scubaben/MixMonitor/(threads)

Thread 1 (2017-06-21):

display mv reading of cells

scubaben, 2017-06-21:
currently, MV readings are only shown while calibrating.  it would be nice to have the option to see MV readings during analysis too.

scubaben, 2017-06-26:
added the mV readings to the right side of the screen by default

Closed 2017-06-26.

Thread 4 (2017-06-21):

add a settings menu

scubaben, 2017-06-21:
there are a handful of new enhancements that will require new menus to configure.  Clicking the button should first bring up a menu, and then allow the user to choose which settings they want to modify.

maybe something like:
- calibrate
- display theroretical HE
- turn cells on or off
- calculate blend
- set targets manually

scubaben, 2017-06-23:
menus:
-calibrate
-set target blend (specify o2/he)
-set target o2 readings (specify sensor readings directly)
-set alarm (three options: off, alarm on O2, alarm on target blend and tolerance)
-display Setup (controls what is shown on the right side of the screen)
--Show sensor MV
--Show target O2
--Show target mix vs theoretical mix

Closed 2017-06-25.

Thread 5 (2017-06-21):

Add battery monitoring

scubaben, 2017-06-21:
the feather uses a voltage divider on pin A9, which we can use to read the voltage of the rechargable battery pack.
https://learn.adafruit.com/adafruit-feather-32u4-basic-proto/power-management

sample code:
#define VBATPIN A9

float measuredvbat = analogRead(VBATPIN);
measuredvbat *= 2;    // we divided by 2, so multiply back
measuredvbat *= 3.3;  // Multiply by 3.3V, our reference voltage
measuredvbat /= 1024; // convert to voltage
Serial.print("VBat: " ); Serial.println(measuredvbat);

scubaben, 2017-06-23:
added function to get battery voltage, currently displayed on the startup screen.  as a side note, I've had the analyzer running for over 24 hours now on a 2000 mah battery and it is still at 3.93v

Closed 2017-06-23.

Thread 9 (2017-07-19):

Sensor class needs some cleanup

notjj, 2017-07-19:
Currently sensor class references global variables, so it is not possible to use it independent of the project... so it should be refactored to not do this.

scubaben, 2017-07-19:
Good callout, it looks like target tolerance is the offending variable - did you spot others?

notjj, 2017-07-20:
Just saw the tolerance pop up in the errors, so I believe it is the only
one. We should probably do per-sensor tolerance even if we set them both
the same at the moment... I could see you possibly being ok with more drift
in one but not the other.

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

scubaben, 2017-07-20:
Made target tolerance a member of the sensor class and eliminated the global variable.

Closed 2017-07-20.
