scubaben/MixMonitor/(commit log)

2017-06-23 improved display and added battery
    created function to read battery voltage and made preparations for adding HE/ MV info to screen by using strings to improve the way decimals are printed (only one decimal place now).
2017-06-25 Added settings menu and divided display
    need to clean up code for calculating when the sensors are within tolerance. do a thorough code review for cleanup opportunities and add code for mix setting still.
    [_2Sensor_Oxygen_Analyzer.ino]
2017-06-25 fixed a few defects
    [_2Sensor_Oxygen_Analyzer.ino]
2017-06-25 moar bug fixes
    need to update the withintolerance variable, displaytargets, and check tolerance functions to handle mix targets too.
    [_2Sensor_Oxygen_Analyzer.ino]
2017-06-30 fixed an issue with the target displaying for disconected sensors
    [_2Sensor_Oxygen_Analyzer.ino]
2017-07-12 changed tolerances for determining if a cell is active
    [_2Sensor_Oxygen_Analyzer.ino]
2017-07-19 Invalidate loaded calibration when new calibration values are saved. Otherwise board has to be reset to re-load new calibraiton
    [_2Sensor_Oxygen_Analyzer.ino]
2017-07-20 made target tolerance a member of the sensor class and eliminated the global variable
    also added an error condition if you try to calibrate with no sensors connected
    [_2Sensor_Oxygen_Analyzer.ino]
2017-07-21 removed print target function and integrated it into print int
2017-07-21 moved calculation of He into its own function and added a function to check HE tolerance
    [_2Sensor_Oxygen_Analyzer.ino]
2017-07-21 Fix inferredHe function. Missing )
    [_2Sensor_Oxygen_Analyzer.ino]
2017-07-21 Move sensor class to its own files, pass adc object to class
2017-08-09 added ability to set gain and upper / lower limits when creating a sensor class
2017-08-10 added ability to set a sensor type, and ability to save calibration 'offsets' for helium sensors
    jj was right
2017-08-10 added function to get sensor type
2017-08-10 added a function to validate calibration data
2017-08-11 added a missing 'this' and updated program to use calibration validation from sensor.cpp
    [Sensor.cpp, _2Sensor_Oxygen_Analyzer.ino]
2017-08-25 fixed a math error for HE and changed the calc of the oxygen factor
    [Sensor.cpp, _2Sensor_Oxygen_Analyzer.ino]
2017-08-26 removed calibration related features for helium sensors and implemented curve fitting for he gas content
2018-03-28 updated sensor.cpp with a better curve fitting equation for helium content
2020-02-18 Added wiring diagram to README
